Onizuka09/OdometryRobot/Imgs/robot2.png

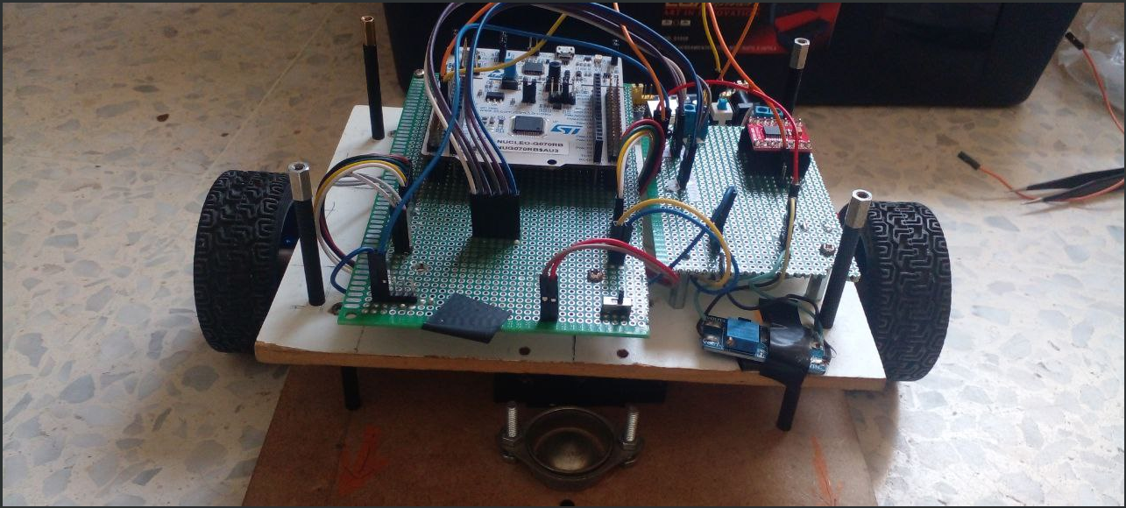
Imgs/robot2.png
