Onizuka09/OdometryRobot/todo.md

# TODO
- [ ] Fix printf (problem with io putchar)
