Onizuka09/OdometryRobot/Core/Inc/main.h

#define BTN_Pin GPIO_PIN_13
#define BTN_GPIO_Port GPIOC
#define MCO_Pin GPIO_PIN_0
#define MCO_GPIO_Port GPIOF
#define PWMA_Pin GPIO_PIN_1
#define PWMA_GPIO_Port GPIOC
#define PWMB_Pin GPIO_PIN_2
#define PWMB_GPIO_Port GPIOC
#define LED_GREEN_Pin GPIO_PIN_5
#define LED_GREEN_GPIO_Port GPIOA
#define BIN2_Pin GPIO_PIN_1
#define BIN2_GPIO_Port GPIOB
#define OUTA1_Pin GPIO_PIN_8
#define OUTA1_GPIO_Port GPIOA
#define OUTA2_Pin GPIO_PIN_9
#define OUTA2_GPIO_Port GPIOA
#define OUTB1_Pin GPIO_PIN_6
#define OUTB1_GPIO_Port GPIOC
#define OUTB2_Pin GPIO_PIN_7
#define OUTB2_GPIO_Port GPIOC
#define AIN1_Pin GPIO_PIN_3
#define AIN1_GPIO_Port GPIOB
#define BIN1_Pin GPIO_PIN_4
#define BIN1_GPIO_Port GPIOB
#define AIN2_Pin GPIO_PIN_5
#define AIN2_GPIO_Port GPIOB
