Onizuka09/OdometryRobot/(commit log)

2025-05-23 finished testing PWM
2025-05-25 finished testing encoders
2025-05-26 Update: - add EXTI on PC13 pin - Fix pwm issues ( reg config and PWM freq calculation )
    [PWM_Test.c, main.c, main2.c, motor.c, motor.h, pwm.c, pwm.h, test.c]
2025-11-28 Major update: - update encoder module - add odometry module and tested it seccessfully - add system_clk module (configuring RCC to use HSI as systemclk 16 Mhz)
2026-01-18 Implement moving average filter for odometry speed calculations
    - Fixed velocity calculation to use actual time delta (dt) instead of hardcoded PERIOD
    - Fixed wheelbase measurment (from centre of the lef wheel to the center
    of the right wheel), instead of only taking the width of the robot.
    - Added a helper to translate from Degrees to radians
    [odometry.c, odometry.h]
2026-01-18 update: - completed the naviagation stack (position command and angular command) - update the motor control logic - fixed uart bsp (for stm32g0 support now instead of stm32f401) - add bsp layer for b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
    [bsp.c, main.c, motor.c, motor.h, navigation.c, navigation.h, pwm.c]
2026-01-24 switched to hal, testing ...
2026-01-25 update
    Test encoder passed
2026-02-02 Update - set system timer to be timer6 instead of systick (preparing for RTOS usage) - configured uart2 and enabled it interrupts for callbacks - fix pwm issues cubeMX wasnt setting the right configs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
    [main.c]
2026-02-02 Version 1.0.0
    This version is template for implementing a navigation stack using the
    STM32G070 no RTOS, no Micro ros just pure navigation.
    This version implement a basic example of a square mission that the
    robot has to perform.
    Checkout the video in the readme.
2026-02-09 Update: - Fix CubeMX issue, encoder config did not get saved (It was using only one channel instead of using 2 channels for the encoder, this issue was notesed by aziz when testing the robot angle_co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
    [ProjAli.ioc, main.c]
2026-02-09 update: - fix indentation and add missing include
    [delay.c]
2026-02-09 update - add support for zetta-protocol - ability to received commands (angle and position) from ros-zetta bridge - ability to send odometry data using the zetta protocol to the ros-zetta bridge
